OskarNoriyuki/PMSM-FOC-PSoC5LP/Test Data/electrical angle vs encoder angle 2 rev.xlsx

 |  |  |  | time_s | angle_mech
> angle_mech | 158 | angle_ele | 43 | 0 | 0
> angle_mech | 160 | angle_ele | 51 | 0.025 | 2
> angle_mech | 162 | angle_ele | 58 | 0.05 | 4
> angle_mech | 164 | angle_ele | 66 | 0.075 | 6
> angle_mech | 165 | angle_ele | 73 | 0.1 | 8
> angle_mech | 167 | angle_ele | 81 | 0.125 | 10
> angle_mech | 169 | angle_ele | 88 | 0.15 | 12
> angle_mech | 171 | angle_ele | 96 | 0.175 | 14
> angle_mech | 173 | angle_ele | 103 | 0.2 | 15
> angle_mech | 175 | angle_ele | 111 | 0.225 | 17
> angle_mech | 177 | angle_ele | 118 | 0.25 | 19
> angle_mech | 178 | angle_ele | 126 | 0.275 | 21
> angle_mech | 180 | angle_ele | 133 | 0.3 | 23
> angle_mech | 182 | angle_ele | 141 | 0.325 | 25
> angle_mech | 184 | angle_ele | 148 | 0.35 | 27
> angle_mech | 186 | angle_ele | 156 | 0.375 | 29
> angle_mech | 187 | angle_ele | 164 | 0.4 | 31
> angle_mech | 189 | angle_ele | 171 | 0.425 | 33
> angle_mech | 191 | angle_ele | 178 | 0.45 | 35
> angle_mech | 193 | angle_ele | 185 | 0.475 | 37
> angle_mech | 195 | angle_ele | 193 | 0.5 | 39
> angle_mech | 196 | angle_ele | 200 | 0.525 | 40
> angle_mech | 198 | angle_ele | 207 | 0.55 | 42
> angle_mech | 200 | angle_ele | 215 | 0.575 | 44
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
