OskarNoriyuki/PMSM-FOC-PSoC5LP/Test Data/position control.xlsx

> zero:0, PosRef:197, PosMeas:204 | > zero:0, PosRef:-30, PosMeas:-30
> zero:0, PosRef:180, PosMeas:186 | > zero:0, PosRef:-30, PosMeas:-30
> zero:0, PosRef:166, PosMeas:171 | > zero:0, PosRef:-30, PosMeas:-30
> zero:0, PosRef:148, PosMeas:155 | > zero:0, PosRef:-30, PosMeas:-30
> zero:0, PosRef:130, PosMeas:139 | > zero:0, PosRef:-30, PosMeas:-30
> zero:0, PosRef:116, PosMeas:126 | > zero:0, PosRef:-30, PosMeas:-30
> zero:0, PosRef:96, PosMeas:106 | > zero:0, PosRef:-30, PosMeas:-30
> zero:0, PosRef:75, PosMeas:84 | > zero:0, PosRef:-30, PosMeas:-30
> zero:0, PosRef:60, PosMeas:68 | > zero:0, PosRef:-30, PosMeas:-30
> zero:0, PosRef:39, PosMeas:45 | > zero:0, PosRef:-30, PosMeas:-30
> zero:0, PosRef:20, PosMeas:21 | > zero:0, PosRef:-30, PosMeas:-30
> zero:0, PosRef:0, PosMeas:-4 | > zero:0, PosRef:-30, PosMeas:-30
> zero:0, PosRef:-14, PosMeas:-23 | > zero:0, PosRef:-30, PosMeas:-30
> zero:0, PosRef:-29, PosMeas:-38 | > zero:0, PosRef:-30, PosMeas:-30
> zero:0, PosRef:-46, PosMeas:-52 | > zero:0, PosRef:-30, PosMeas:-30
> zero:0, PosRef:-60, PosMeas:-62 | > zero:0, PosRef:-30, PosMeas:-30
> zero:0, PosRef:-73, PosMeas:-72 | > zero:0, PosRef:-30, PosMeas:-30
> zero:0, PosRef:-91, PosMeas:-84 | > zero:0, PosRef:-30, PosMeas:-30
> zero:0, PosRef:-104, PosMeas:-97 | > zero:0, PosRef:-30, PosMeas:-30
> zero:0, PosRef:-117, PosMeas:-112 | > zero:0, PosRef:-30, PosMeas:-30
> zero:0, PosRef:-127, PosMeas:-123 | > zero:0, PosRef:-30, PosMeas:-30
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
> zero:0, PosRef:-30, PosMeas:-30 | > zero:0, PosRef:-253, PosMeas:-253
> zero:0, PosRef:-30, PosMeas:-30 | > zero:0, PosRef:-253, PosMeas:-253
> zero:0, PosRef:-30, PosMeas:-30 | > zero:0, PosRef:-253, PosMeas:-253
> zero:0, PosRef:-30, PosMeas:-30 | > zero:0, PosRef:-253, PosMeas:-253
