OskarNoriyuki/PMSM-FOC-PSoC5LP/Test Data/speed control.xlsx

> zero | 0 | SpeedRef | -3062 | SpeedMeas | -2694 | > zero:0, SpeedRef:30249, SpeedMeas:29468
> zero | 0 | SpeedRef | -3049 | SpeedMeas | -4159 | > zero:0, SpeedRef:30281, SpeedMeas:29365
> zero | 0 | SpeedRef | -3067 | SpeedMeas | -2688 | > zero:0, SpeedRef:30226, SpeedMeas:30076
> zero | 0 | SpeedRef | -3110 | SpeedMeas | -4185 | > zero:0, SpeedRef:30233, SpeedMeas:29665
> zero | 0 | SpeedRef | -3062 | SpeedMeas | -3815 | > zero:0, SpeedRef:30231, SpeedMeas:29348
> zero | 0 | SpeedRef | -3078 | SpeedMeas | -1976 | > zero:0, SpeedRef:30222, SpeedMeas:29297
> zero | 0 | SpeedRef | -3078 | SpeedMeas | -1884 | > zero:0, SpeedRef:30213, SpeedMeas:29503
> zero | 0 | SpeedRef | -3046 | SpeedMeas | -1746 | > zero:0, SpeedRef:30210, SpeedMeas:30225
> zero | 0 | SpeedRef | -3036 | SpeedMeas | -1861 | > zero:0, SpeedRef:30225, SpeedMeas:30058
> zero | 0 | SpeedRef | -3038 | SpeedMeas | -1570 | > zero:0, SpeedRef:30233, SpeedMeas:29710
> zero | 0 | SpeedRef | -3063 | SpeedMeas | -4492 | > zero:0, SpeedRef:30226, SpeedMeas:32595
> zero | 0 | SpeedRef | -3053 | SpeedMeas | -941 | > zero:0, SpeedRef:30199, SpeedMeas:30808
> zero | 0 | SpeedRef | -3126 | SpeedMeas | -3148 | > zero:0, SpeedRef:30175, SpeedMeas:30052
> zero | 0 | SpeedRef | -3175 | SpeedMeas | -3354 | > zero:0, SpeedRef:30198, SpeedMeas:31153
> zero | 0 | SpeedRef | -3545 | SpeedMeas | -1707 | > zero:0, SpeedRef:30218, SpeedMeas:30035
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
> zero | 0 | SpeedRef | -99999 | SpeedMeas | -99607 | > zero:0, SpeedRef:28612, SpeedMeas:29331
> zero | 0 | SpeedRef | -99999 | SpeedMeas | -100735 | > zero:0, SpeedRef:27869, SpeedMeas:29209
> zero | 0 | SpeedRef | -99999 | SpeedMeas | -100353 | > zero:0, SpeedRef:25939, SpeedMeas:29296
> zero | 0 | SpeedRef | -99999 | SpeedMeas | -102748 | > zero:0, SpeedRef:24940, SpeedMeas:29251
> zero | 0 | SpeedRef | -99999 | SpeedMeas | -102563 | > zero:0, SpeedRef:22448, SpeedMeas:25513
> zero | 0 | SpeedRef | -99999 | SpeedMeas | -99656 | > zero:0, SpeedRef:19112, SpeedMeas:22024
> zero | 0 | SpeedRef | -99999 | SpeedMeas | -99609 | > zero:0, SpeedRef:17098, SpeedMeas:24995
> zero | 0 | SpeedRef | -99999 | SpeedMeas | -96679 | > zero:0, SpeedRef:13109, SpeedMeas:22566
> zero | 0 | SpeedRef | -99999 | SpeedMeas | -99612 | > zero:0, SpeedRef:8242, SpeedMeas:16116
> zero | 0 | SpeedRef | -99999 | SpeedMeas | -98864 | > zero:0, SpeedRef:5604, SpeedMeas:14461
> zero | 0 | SpeedRef | -99999 | SpeedMeas | -98865 | > zero:0, SpeedRef:224, SpeedMeas:11736
> zero | 0 | SpeedRef | -99999 | SpeedMeas | -99976 | > zero:0, SpeedRef:-2349, SpeedMeas:10139
> zero | 0 | SpeedRef | -99999 | SpeedMeas | -100367 | > zero:0, SpeedRef:-7090, SpeedMeas:5865
> zero | 0 | SpeedRef | -99999 | SpeedMeas | -103378 | > zero:0, SpeedRef:-12596, SpeedMeas:-726
> zero | 0 | SpeedRef | -99999 | SpeedMeas | -101133 | > zero:0, SpeedRef:-15475, SpeedMeas:-3525
> zero | 0 | SpeedRef | -99999 | SpeedMeas | -102582 | > zero:0, SpeedRef:-21285, SpeedMeas:-6317
> zero | 0 | SpeedRef | -99999 | SpeedMeas | -101623 | > zero:0, SpeedRef:-24523, SpeedMeas:-10557
> zero | 0 | SpeedRef | -99999 | SpeedMeas | -99609 | > zero:0, SpeedRef:-30785, SpeedMeas:-15037
> zero | 0 | SpeedRef | -99999 | SpeedMeas | -99609 | > zero:0, SpeedRef:-35783, SpeedMeas:-15991
> zero | 0 | SpeedRef | -99999 | SpeedMeas | -98087 | > zero:0, SpeedRef:-44427, SpeedMeas:-23432
> zero | 0 | SpeedRef | -99999 | SpeedMeas | -99328 | > zero:0, SpeedRef:-49159, SpeedMeas:-28319
> zero | 0 | SpeedRef | -99999 | SpeedMeas | -99613 | > zero:0, SpeedRef:-58217, SpeedMeas:-32173
> zero | 0 | SpeedRef | -99999 | SpeedMeas | -99978 | > zero:0, SpeedRef:-64849, SpeedMeas:-40587
> zero | 0 | SpeedRef | -99999 | SpeedMeas | -100760 | > zero:0, SpeedRef:-76073, SpeedMeas:-46813
> zero | 0 | SpeedRef | -99999 | SpeedMeas | -99989 | > zero:0, SpeedRef:-81441, SpeedMeas:-47802
> zero | 0 | SpeedRef | -99999 | SpeedMeas | -98832 | > zero:0, SpeedRef:-91811, SpeedMeas:-54589
> zero | 0 | SpeedRef | -99999 | SpeedMeas | -99612 | > zero:0, SpeedRef:-96422, SpeedMeas:-58403
> zero | 0 | SpeedRef | -99999 | SpeedMeas | -99563 | > zero:0, SpeedRef:-99399, SpeedMeas:-64404
> zero | 0 | SpeedRef | -99999 | SpeedMeas | -99671 | > zero:0, SpeedRef:-99754, SpeedMeas:-68598
> zero | 0 | SpeedRef | -99999 | SpeedMeas | -99234 | > zero:0, SpeedRef:-99958, SpeedMeas:-71273
> zero | 0 | SpeedRef | -99999 | SpeedMeas | -99516 | > zero:0, SpeedRef:-99983, SpeedMeas:-76131
> zero | 0 | SpeedRef | -97637 | SpeedMeas | -99609 | > zero:0, SpeedRef:-99997, SpeedMeas:-80350
> zero | 0 | SpeedRef | -95082 | SpeedMeas | -101166 | > zero:0, SpeedRef:-99998, SpeedMeas:-82600
> zero | 0 | SpeedRef | -88743 | SpeedMeas | -99655 | > zero:0, SpeedRef:-99999, SpeedMeas:-87142
> zero | 0 | SpeedRef | -85210 | SpeedMeas | -95123 | > zero:0, SpeedRef:-99999, SpeedMeas:-87935
> zero | 0 | SpeedRef | -77470 | SpeedMeas | -90448 | > zero:0, SpeedRef:-99999, SpeedMeas:-92236
> zero | 0 | SpeedRef | -73313 | SpeedMeas | -88101 | > zero:0, SpeedRef:-99999, SpeedMeas:-95214
> zero | 0 | SpeedRef | -65149 | SpeedMeas | -82245 | > zero:0, SpeedRef:-99999, SpeedMeas:-95639
> zero | 0 | SpeedRef | -61003 | SpeedMeas | -78323 | > zero:0, SpeedRef:-99999, SpeedMeas:-96581
> zero | 0 | SpeedRef | -53159 | SpeedMeas | -70734 | > zero:0, SpeedRef:-99999, SpeedMeas:-99515
> zero | 0 | SpeedRef | -49396 | SpeedMeas | -65526 | > zero:0, SpeedRef:-99999, SpeedMeas:-101079
> zero | 0 | SpeedRef | -42897 | SpeedMeas | -59445 | > zero:0, SpeedRef:-99999, SpeedMeas:-99982
> zero | 0 | SpeedRef | -39768 | SpeedMeas | -56739 | > zero:0, SpeedRef:-99999, SpeedMeas:-100537
> zero | 0 | SpeedRef | -34153 | SpeedMeas | -50227 | > zero:0, SpeedRef:-99999, SpeedMeas:-101859
> zero | 0 | SpeedRef | -31922 | SpeedMeas | -44654 | > zero:0, SpeedRef:-99999, SpeedMeas:-102302
> zero | 0 | SpeedRef | -27971 | SpeedMeas | -38208 | > zero:0, SpeedRef:-99999, SpeedMeas:-102510
> zero | 0 | SpeedRef | -26435 | SpeedMeas | -34057 | > zero:0, SpeedRef:-99999, SpeedMeas:-102490
> zero | 0 | SpeedRef | -23258 | SpeedMeas | -26255 | > zero:0, SpeedRef:-99999, SpeedMeas:-102245
> zero | 0 | SpeedRef | -21781 | SpeedMeas | -24277 | > zero:0, SpeedRef:-99999, SpeedMeas:-104710
> zero | 0 | SpeedRef | -20289 | SpeedMeas | -18464 | > zero:0, SpeedRef:-99999, SpeedMeas:-105003
> zero | 0 | SpeedRef | -19522 | SpeedMeas | -17590 | > zero:0, SpeedRef:-99999, SpeedMeas:-101378
> zero | 0 | SpeedRef | -18259 | SpeedMeas | -13428 | > zero:0, SpeedRef:-99999, SpeedMeas:-102781
> zero | 0 | SpeedRef | -17848 | SpeedMeas | -12109 | > zero:0, SpeedRef:-99999, SpeedMeas:-100445
> zero | 0 | SpeedRef | -16904 | SpeedMeas | -10905 | > zero:0, SpeedRef:-99999, SpeedMeas:-103023
> zero | 0 | SpeedRef | -16299 | SpeedMeas | -7808 | > zero:0, SpeedRef:-99999, SpeedMeas:-103514
> zero | 0 | SpeedRef | -15875 | SpeedMeas | -6231 | > zero:0, SpeedRef:-99999, SpeedMeas:-101744
> zero | 0 | SpeedRef | -15697 | SpeedMeas | -6225 | > zero:0, SpeedRef:-99999, SpeedMeas:-104524
> zero | 0 | SpeedRef | -15622 | SpeedMeas | -5865 | > zero:0, SpeedRef:-99999, SpeedMeas:-100440
> zero | 0 | SpeedRef | -15560 | SpeedMeas | -5950 | > zero:0, SpeedRef:-99999, SpeedMeas:-102772
> zero | 0 | SpeedRef | -15546 | SpeedMeas | -5996 | > zero:0, SpeedRef:-99999, SpeedMeas:-101177
> zero | 0 | SpeedRef | -15576 | SpeedMeas | -8836 | > zero:0, SpeedRef:-99999, SpeedMeas:-102631
> zero | 0 | SpeedRef | -15568 | SpeedMeas | -7372 | > zero:0, SpeedRef:-99999, SpeedMeas:-99507
> zero | 0 | SpeedRef | -15622 | SpeedMeas | -9639 | > zero:0, SpeedRef:-99999, SpeedMeas:-99597
> zero | 0 | SpeedRef | -15651 | SpeedMeas | -8499 | > zero:0, SpeedRef:-99999, SpeedMeas:-100364
> zero | 0 | SpeedRef | -15707 | SpeedMeas | -10063 | > zero:0, SpeedRef:-99999, SpeedMeas:-103102
> zero | 0 | SpeedRef | -15716 | SpeedMeas | -11316 | > zero:0, SpeedRef:-99999, SpeedMeas:-100595
> zero | 0 | SpeedRef | -15737 | SpeedMeas | -11351 | > zero:0, SpeedRef:-99999, SpeedMeas:-102636
> zero | 0 | SpeedRef | -15715 | SpeedMeas | -11632 | > zero:0, SpeedRef:-99999, SpeedMeas:-101086
> zero | 0 | SpeedRef | -15703 | SpeedMeas | -11901 | > zero:0, SpeedRef:-99999, SpeedMeas:-102377
> zero | 0 | SpeedRef | -15697 | SpeedMeas | -11764 | > zero:0, SpeedRef:-99999, SpeedMeas:-99243
> zero | 0 | SpeedRef | -15740 | SpeedMeas | -15040 | > zero:0, SpeedRef:-99999, SpeedMeas:-99450
> zero | 0 | SpeedRef | -15730 | SpeedMeas | -13235 | > zero:0, SpeedRef:-99999, SpeedMeas:-98829
> zero | 0 | SpeedRef | -15733 | SpeedMeas | -13415 | > zero:0, SpeedRef:-99999, SpeedMeas:-98850
> zero | 0 | SpeedRef | -15715 | SpeedMeas | -12687 | > zero:0, SpeedRef:-99999, SpeedMeas:-99700
> zero | 0 | SpeedRef | -15699 | SpeedMeas | -13677 | > zero:0, SpeedRef:-99999, SpeedMeas:-100087
> zero | 0 | SpeedRef | -15688 | SpeedMeas | -15623 | > zero:0, SpeedRef:-99999, SpeedMeas:-101996
> zero | 0 | SpeedRef | -15718 | SpeedMeas | -13764 | > zero:0, SpeedRef:-99999, SpeedMeas:-99609
> zero | 0 | SpeedRef | -15719 | SpeedMeas | -14152 | > zero:0, SpeedRef:-99999, SpeedMeas:-99586
> zero | 0 | SpeedRef | -15689 | SpeedMeas | -13809 | > zero:0, SpeedRef:-99999, SpeedMeas:-99603
> zero | 0 | SpeedRef | -15680 | SpeedMeas | -13811 | > zero:0, SpeedRef:-99999, SpeedMeas:-99609
> zero | 0 | SpeedRef | -15707 | SpeedMeas | -16009 | > zero:0, SpeedRef:-99999, SpeedMeas:-96490
> zero | 0 | SpeedRef | -15685 | SpeedMeas | -14553 | > zero:0, SpeedRef:-99999, SpeedMeas:-96839
> zero | 0 | SpeedRef | -15706 | SpeedMeas | -17474 | > zero:0, SpeedRef:-99999, SpeedMeas:-99718
> zero | 0 | SpeedRef | -15681 | SpeedMeas | -16805 | > zero:0, SpeedRef:-99999, SpeedMeas:-100067
> zero | 0 | SpeedRef | -15736 | SpeedMeas | -17188 | > zero:0, SpeedRef:-99999, SpeedMeas:-104492
> zero | 0 | SpeedRef | -15713 | SpeedMeas | -16798 | > zero:0, SpeedRef:-99999, SpeedMeas:-102967
> zero | 0 | SpeedRef | -15692 | SpeedMeas | -16834 | > zero:0, SpeedRef:-99999, SpeedMeas:-99978
> zero | 0 | SpeedRef | -15694 | SpeedMeas | -17394 | > zero:0, SpeedRef:-99999, SpeedMeas:-100090
> zero | 0 | SpeedRef | -15727 | SpeedMeas | -17188 | > zero:0, SpeedRef:-99999, SpeedMeas:-96720
> zero | 0 | SpeedRef | -15709 | SpeedMeas | -16730 | > zero:0, SpeedRef:-99999, SpeedMeas:-99884
> zero | 0 | SpeedRef | -15708 | SpeedMeas | -15734 | > zero:0, SpeedRef:-99999, SpeedMeas:-98864
> zero | 0 | SpeedRef | -15697 | SpeedMeas | -14545 | > zero:0, SpeedRef:-99999, SpeedMeas:-95116
> zero | 0 | SpeedRef | -15704 | SpeedMeas | -18261 | > zero:0, SpeedRef:-99999, SpeedMeas:-99058
> zero | 0 | SpeedRef | -15688 | SpeedMeas | -15310 | > zero:0, SpeedRef:-99999, SpeedMeas:-102928
> zero | 0 | SpeedRef | -15702 | SpeedMeas | -13699 | > zero:0, SpeedRef:-99999, SpeedMeas:-102109
> zero | 0 | SpeedRef | -15687 | SpeedMeas | -15809 | > zero:0, SpeedRef:-99999, SpeedMeas:-103035
> zero | 0 | SpeedRef | -15700 | SpeedMeas | -13513 | > zero:0, SpeedRef:-99999, SpeedMeas:-100367
> zero | 0 | SpeedRef | -15703 | SpeedMeas | -15259 | > zero:0, SpeedRef:-99999, SpeedMeas:-99748
> zero | 0 | SpeedRef | -15711 | SpeedMeas | -15602 | > zero:0, SpeedRef:-99999, SpeedMeas:-99609
> zero | 0 | SpeedRef | -15698 | SpeedMeas | -13656 | > zero:0, SpeedRef:-99999, SpeedMeas:-99615
> zero | 0 | SpeedRef | -15725 | SpeedMeas | -15671 | > zero:0, SpeedRef:-99999, SpeedMeas:-98050
> zero | 0 | SpeedRef | -15706 | SpeedMeas | -15510 | > zero:0, SpeedRef:-99999, SpeedMeas:-97931
> zero | 0 | SpeedRef | -15701 | SpeedMeas | -16427 | > zero:0, SpeedRef:-99999, SpeedMeas:-99517
> zero | 0 | SpeedRef | -15687 | SpeedMeas | -14172 | > zero:0, SpeedRef:-99999, SpeedMeas:-101898
> zero | 0 | SpeedRef | -15707 | SpeedMeas | -15823 | > zero:0, SpeedRef:-98967, SpeedMeas:-104521
> zero | 0 | SpeedRef | -15723 | SpeedMeas | -16645 | > zero:0, SpeedRef:-97138, SpeedMeas:-103012
> zero | 0 | SpeedRef | -15736 | SpeedMeas | -16740 | > zero:0, SpeedRef:-92449, SpeedMeas:-99251
> zero | 0 | SpeedRef | -15745 | SpeedMeas | -15693 | > zero:0, SpeedRef:-89765, SpeedMeas:-95110
> zero | 0 | SpeedRef | -15758 | SpeedMeas | -16773 | > zero:0, SpeedRef:-84787, SpeedMeas:-93844
> zero | 0 | SpeedRef | -15703 | SpeedMeas | -14211 | > zero:0, SpeedRef:-80939, SpeedMeas:-93006
> zero | 0 | SpeedRef | -15711 | SpeedMeas | -15723 | > zero:0, SpeedRef:-74090, SpeedMeas:-86425
> zero | 0 | SpeedRef | -15706 | SpeedMeas | -15904 | > zero:0, SpeedRef:-70170, SpeedMeas:-82147
> zero | 0 | SpeedRef | -15731 | SpeedMeas | -18572 | > zero:0, SpeedRef:-62593, SpeedMeas:-78125
> zero | 0 | SpeedRef | -15726 | SpeedMeas | -17389 | > zero:0, SpeedRef:-58517, SpeedMeas:-73471
> zero | 0 | SpeedRef | -15723 | SpeedMeas | -14416 | > zero:0, SpeedRef:-50051, SpeedMeas:-70411
> zero | 0 | SpeedRef | -15713 | SpeedMeas | -16822 | > zero:0, SpeedRef:-45922, SpeedMeas:-66178
> zero | 0 | SpeedRef | -15728 | SpeedMeas | -19763 | > zero:0, SpeedRef:-36745, SpeedMeas:-58321
> zero | 0 | SpeedRef | -15696 | SpeedMeas | -17394 | > zero:0, SpeedRef:-32008, SpeedMeas:-52759
> zero | 0 | SpeedRef | -15711 | SpeedMeas | -17371 | > zero:0, SpeedRef:-22171, SpeedMeas:-41230
> zero | 0 | SpeedRef | -15689 | SpeedMeas | -17118 | > zero:0, SpeedRef:-17271, SpeedMeas:-37112
> zero | 0 | SpeedRef | -15723 | SpeedMeas | -14550 | > zero:0, SpeedRef:-7684, SpeedMeas:-25542
> zero | 0 | SpeedRef | -15718 | SpeedMeas | -17165 | > zero:0, SpeedRef:1435, SpeedMeas:-14286
> zero | 0 | SpeedRef | -15722 | SpeedMeas | -16796 | > zero:0, SpeedRef:5997, SpeedMeas:-8094
> zero | 0 | SpeedRef | -15712 | SpeedMeas | -16454 | > zero:0, SpeedRef:13711, SpeedMeas:-428
> zero | 0 | SpeedRef | -15692 | SpeedMeas | -13794 | > zero:0, SpeedRef:21890, SpeedMeas:9658
> zero | 0 | SpeedRef | -15610 | SpeedMeas | -13485 | > zero:0, SpeedRef:26098, SpeedMeas:14642
> zero | 0 | SpeedRef | -15259 | SpeedMeas | -16602 | > zero:0, SpeedRef:33592, SpeedMeas:22064
> zero | 0 | SpeedRef | -14710 | SpeedMeas | -13700 | > zero:0, SpeedRef:42841, SpeedMeas:28049
> zero | 0 | SpeedRef | -13064 | SpeedMeas | -13426 | > zero:0, SpeedRef:47258, SpeedMeas:32224
> zero | 0 | SpeedRef | -10938 | SpeedMeas | -15113 | > zero:0, SpeedRef:56638, SpeedMeas:38463
> zero | 0 | SpeedRef | -7553 | SpeedMeas | -12108 | > zero:0, SpeedRef:61366, SpeedMeas:40817
> zero | 0 | SpeedRef | -3748 | SpeedMeas | -14330 | > zero:0, SpeedRef:70669, SpeedMeas:49114
> zero | 0 | SpeedRef | -334 | SpeedMeas | -10042 | > zero:0, SpeedRef:74937, SpeedMeas:52306
> zero | 0 | SpeedRef | 5401 | SpeedMeas | -8081 | > zero:0, SpeedRef:82916, SpeedMeas:58544
> zero | 0 | SpeedRef | 10138 | SpeedMeas | -3290 | > zero:0, SpeedRef:86585, SpeedMeas:61946
> zero | 0 | SpeedRef | 17456 | SpeedMeas | 2929 | > zero:0, SpeedRef:92397, SpeedMeas:69047
> zero | 0 | SpeedRef | 26333 | SpeedMeas | 6956 | > zero:0, SpeedRef:96571, SpeedMeas:72863
> zero | 0 | SpeedRef | 34435 | SpeedMeas | 8729 | > zero:0, SpeedRef:99242, SpeedMeas:74602
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
> zero | 0 | SpeedRef | -472 | SpeedMeas | -778 | > zero:0, SpeedRef:99951, SpeedMeas:100585
> zero | 0 | SpeedRef | -473 | SpeedMeas | -390 | > zero:0, SpeedRef:99951, SpeedMeas:102839
> zero | 0 | SpeedRef | -471 | SpeedMeas | -3024 | > zero:0, SpeedRef:99951, SpeedMeas:99804
> zero | 0 | SpeedRef | -483 | SpeedMeas | -374 | > zero:0, SpeedRef:99951, SpeedMeas:101086
> zero | 0 | SpeedRef | -458 | SpeedMeas | -35 | > zero:0, SpeedRef:99951, SpeedMeas:99975
> zero | 0 | SpeedRef | -446 | SpeedMeas | -276 | > zero:0, SpeedRef:99951, SpeedMeas:99563
> zero | 0 | SpeedRef | -465 | SpeedMeas | -2932 | > zero:0, SpeedRef:99951, SpeedMeas:95855
> zero | 0 | SpeedRef | -434 | SpeedMeas | -733 | > zero:0, SpeedRef:99951, SpeedMeas:97936
