OskarNoriyuki/PMSM-FOC-PSoC5LP/Test Data/valbe theta zero encoder offset meas.xlsx

> angle_mech:333, angle_ele:0 | > angle_mech:62, angle_ele:0 | Rodada | Direção de chegada | encoder meas (raw) |  | Tensão: 0.8 V
> angle_mech:333, angle_ele:0 | > angle_mech:62, angle_ele:0 | 1 | 0 | 735
> angle_mech:333, angle_ele:0 | > angle_mech:63, angle_ele:0 | 2 | 0 | 735
> angle_mech:333, angle_ele:0 | > angle_mech:63, angle_ele:0 | 3 | 0 | 735
> angle_mech:333, angle_ele:0 | > angle_mech:64, angle_ele:0 | 4 | 0 | 736
> angle_mech:333, angle_ele:0 | > angle_mech:65, angle_ele:0 | 5 | 0 | 736
> angle_mech:333, angle_ele:0 | > angle_mech:66, angle_ele:0 | 1 | 1 | 757
> angle_mech:333, angle_ele:0 | > angle_mech:66, angle_ele:0 | 2 | 1 | 757
> angle_mech:333, angle_ele:0 | > angle_mech:67, angle_ele:0 | 3 | 1 | 757
> angle_mech:333, angle_ele:0 | > angle_mech:67, angle_ele:0 | 4 | 1 | 757
> angle_mech:333, angle_ele:0 | > angle_mech:67, angle_ele:0 | 5 | 1 | 757 | raw | norm.
> angle_mech:333, angle_ele:0 | > angle_mech:67, angle_ele:0 |  | offset (ponto de equilibrio acima) | 746.5 | 746 | 746
> angle_mech:333, angle_ele:0 | > angle_mech:67, angle_ele:0 | Rodada | Direção de chegada | Angulo
> angle_mech:333, angle_ele:0 | > angle_mech:67, angle_ele:0 | 1 | 0 | 3799
> angle_mech:333, angle_ele:0 | > angle_mech:66, angle_ele:0 | 2 | 0 | 3800
> angle_mech:333, angle_ele:0 | > angle_mech:66, angle_ele:0 | 3 | 0 | 3801
> angle_mech:333, angle_ele:0 | > angle_mech:66, angle_ele:0 | 4 | 0 | 3802
> angle_mech:333, angle_ele:0 | > angle_mech:66, angle_ele:0 | 5 | 0 | 3802
> angle_mech:333, angle_ele:0 | > angle_mech:66, angle_ele:0 | 1 | 1 | 3815
> angle_mech:333, angle_ele:0 | > angle_mech:66, angle_ele:0 | 2 | 1 | 3816
> angle_mech:333, angle_ele:0 | > angle_mech:66, angle_ele:0 | 3 | 1 | 3815
> angle_mech:333, angle_ele:0 | > angle_mech:66, angle_ele:0 | 4 | 1 | 3816
> angle_mech:333, angle_ele:0 | > angle_mech:66, angle_ele:0 | 5 | 1 | 3816 | raw | norm.
> angle_mech:333, angle_ele:0 | > angle_mech:66, angle_ele:0 |  | offset (ponto de equilibrio abaixo) | 3808.500 | 3808 | -288
> angle_mech:333, angle_ele:0 | > angle_mech:66, angle_ele:0
> angle_mech:333, angle_ele:0 | > angle_mech:66, angle_ele:0 |  |  |  | diff | 1034
> angle_mech:333, angle_ele:0 | > angle_mech:66, angle_ele:0
> angle_mech:333, angle_ele:0 | > angle_mech:66, angle_ele:0
> angle_mech:333, angle_ele:0 | > angle_mech:66, angle_ele:0
> angle_mech:333, angle_ele:0 | > angle_mech:66, angle_ele:0 |  | encoder meas (raw) | jump
> angle_mech:333, angle_ele:0 | > angle_mech:66, angle_ele:0 | valley 0 | 738
> angle_mech:333, angle_ele:0 | > angle_mech:66, angle_ele:0 | valley 1 | 1757 | 1019
> angle_mech:333, angle_ele:0 | > angle_mech:66, angle_ele:0 | valley 2 | 2784 | 1027
> angle_mech:333, angle_ele:0 | > angle_mech:66, angle_ele:0 | valley 3 | 3814 | 1030
> angle_mech:333, angle_ele:0 | > angle_mech:66, angle_ele:0 |  |  | 1020
> angle_mech:333, angle_ele:0 | > angle_mech:66, angle_ele:0 |  |  | 1023.5
> angle_mech:333, angle_ele:0 | > angle_mech:66, angle_ele:0
> angle_mech:333, angle_ele:0 | > angle_mech:66, angle_ele:0
> angle_mech:333, angle_ele:0 | > angle_mech:66, angle_ele:0
> angle_mech:333, angle_ele:0 | > angle_mech:66, angle_ele:0 |  |  |  | > angle_mech_raw:3644, angle_ele:212
> angle_mech:333, angle_ele:0 | > angle_mech:66, angle_ele:0 |  |  |  | > angle_mech_raw:3649, angle_ele:214
> angle_mech:333, angle_ele:0 | > angle_mech:66, angle_ele:0 |  |  |  | > angle_mech_raw:3654, angle_ele:216
> angle_mech:333, angle_ele:0 | > angle_mech:66, angle_ele:0 |  |  |  | > angle_mech_raw:3659, angle_ele:217
> angle_mech:333, angle_ele:0 | > angle_mech:66, angle_ele:0 |  |  |  | > angle_mech_raw:3664, angle_ele:219
> angle_mech:333, angle_ele:0 | > angle_mech:66, angle_ele:0 |  |  |  | > angle_mech_raw:3669, angle_ele:221
> angle_mech:333, angle_ele:0 | > angle_mech:66, angle_ele:0 |  |  |  | > angle_mech_raw:3673, angle_ele:223
> angle_mech:333, angle_ele:0 | > angle_mech:66, angle_ele:0 |  |  |  | > angle_mech_raw:3677, angle_ele:225
> angle_mech:333, angle_ele:0 | > angle_mech:66, angle_ele:0 |  |  |  | > angle_mech_raw:3683, angle_ele:227
> angle_mech:333, angle_ele:0 | > angle_mech:66, angle_ele:0 |  |  |  | > angle_mech_raw:3687, angle_ele:228
> angle_mech:333, angle_ele:0 | > angle_mech:66, angle_ele:0 |  |  |  | > angle_mech_raw:3692, angle_ele:230
> angle_mech:333, angle_ele:0 | > angle_mech:66, angle_ele:0 |  |  |  | > angle_mech_raw:3698, angle_ele:232
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
 | > angle_mech:65, angle_ele:0
 | > angle_mech:65, angle_ele:0
 | > angle_mech:65, angle_ele:0
 | > angle_mech:65, angle_ele:0
 | > angle_mech:65, angle_ele:0
 | > angle_mech:65, angle_ele:0
 | > angle_mech:65, angle_ele:0
 | > angle_mech:65, angle_ele:0
 | > angle_mech:65, angle_ele:0
