OskarNoriyuki/PMSM-FOC-PSoC5LP/Hardware/Angle Sensor/PCB_PCB_A1339_LINIX_MOTOR_single_2026-07-07.pdf

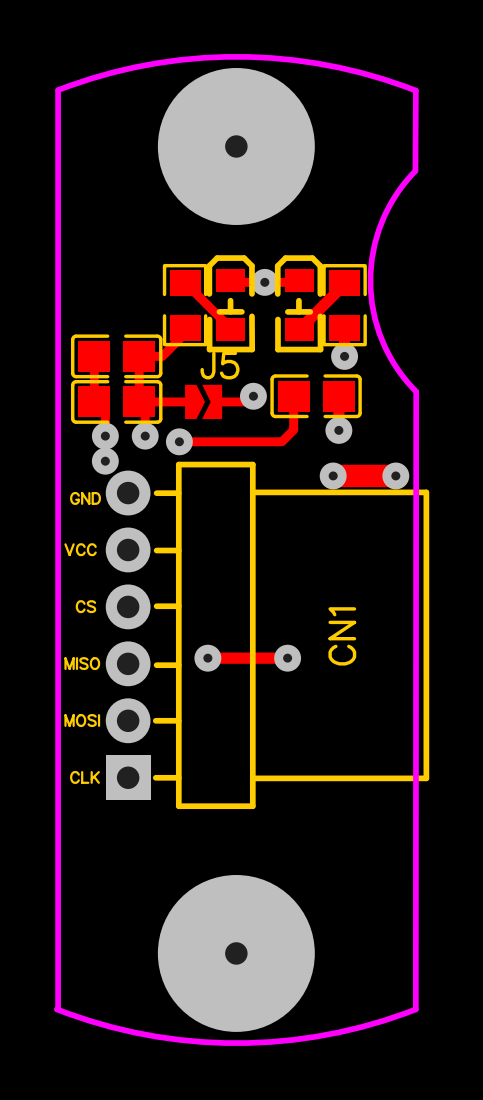
[picture p7: page 1]
