OskarNoriyuki/PMSM-FOC-PSoC5LP/Hardware/Control Board/PCB_PCB_TCC_ControlBoard_2026-07-07.pdf

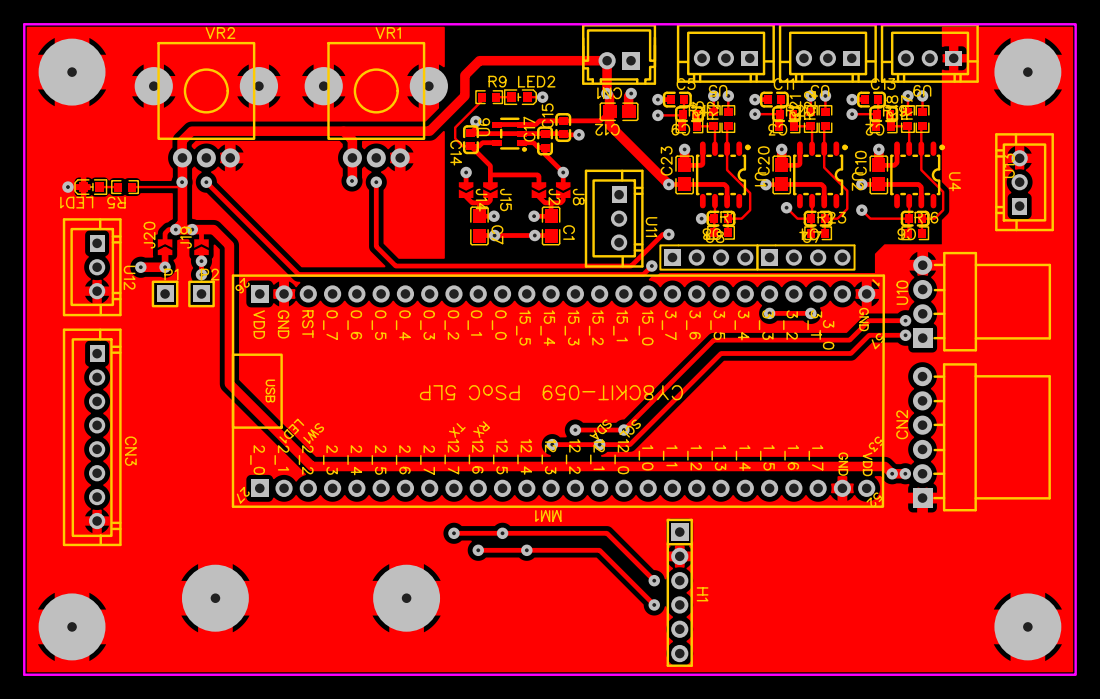
[picture p8: page 1]
