OskarNoriyuki/PMSM-FOC-PSoC5LP/Hardware/Current Sensor/PCB_PCB_Munique_Current_Sensor-copy_2026-07-07.pdf

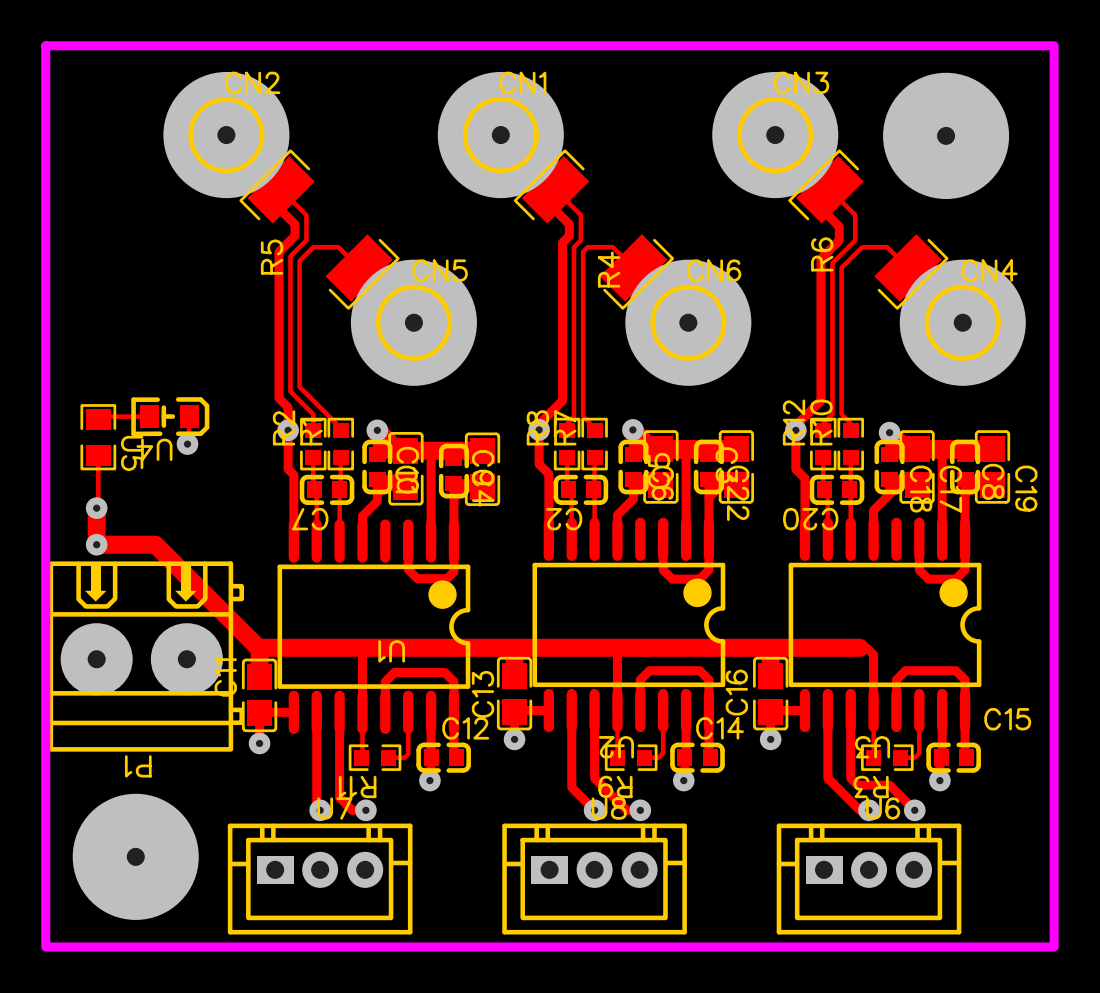
[picture p9: page 1]
