OskarNoriyuki/PMSM-FOC-PSoC5LP/Hardware/Power Stage/PCB_PCB_TCC_PowerStage_2_2026-07-07.pdf

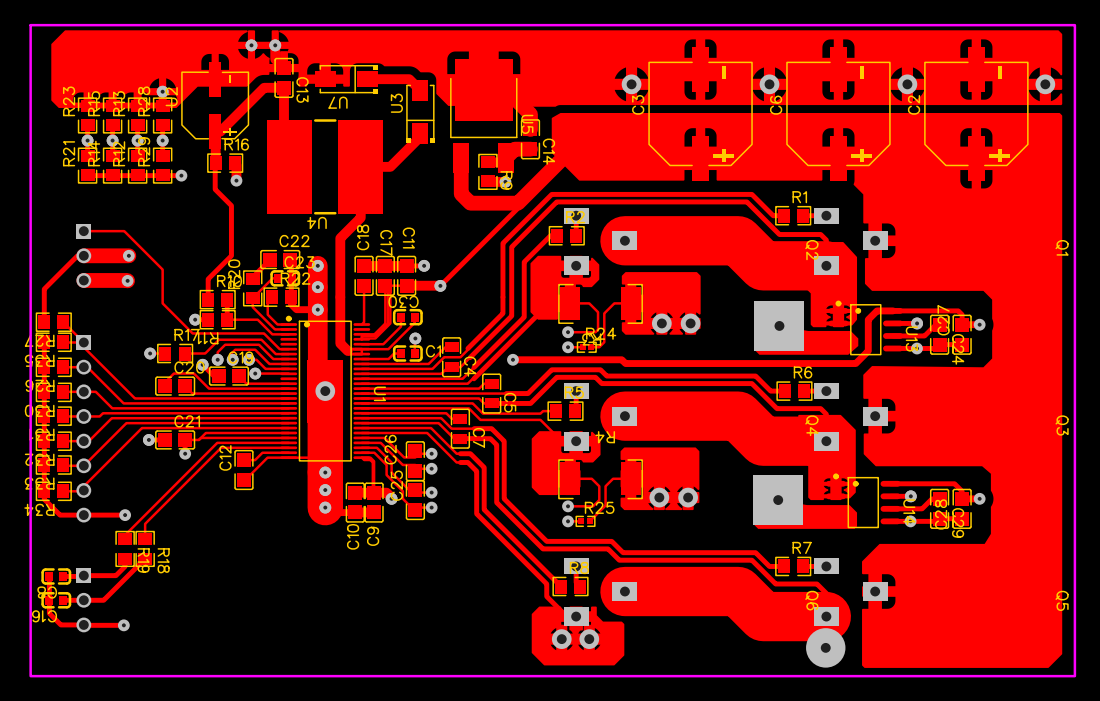
[picture p10: page 1]
